kaipapar/Neulatuntimittari/documentation/the_box.md

[25.10.23](25.10.23)
ideas: 
cutting and carving out from oak kitchen counter material.
otherwise should be similar idea to how it started. 
Q: Can the reed + esp + waveshare be in the same box as was the original plan?

the screen is quite big. 37x83.5 mm. I guess the most space efficient way would be to package them all in the same box but fitting it on the Lenco becomes a question.

because the main box needs to contain the screen it will be as big as it will be. Ergo putting the reed switch in there or in it's own box is irrelevant because the main box won't change[^1]

The smaller box(es) shall be identical in dimensions so they'll look nice. Only difference will be an aperture for the IR sensor to see which the reed box wont have. The reed box will just have a hole where where the leads go in and nothing much more.

[^1]: it will change because when I put the reed in the main box there needs to be a crevice for the reed. But it won't change the exterior of the box in any way

#### [25.10.24](25.10.24)
