kaipapar/Neulatuntimittari/documentation/attachments/IMG20250628234006.jpg

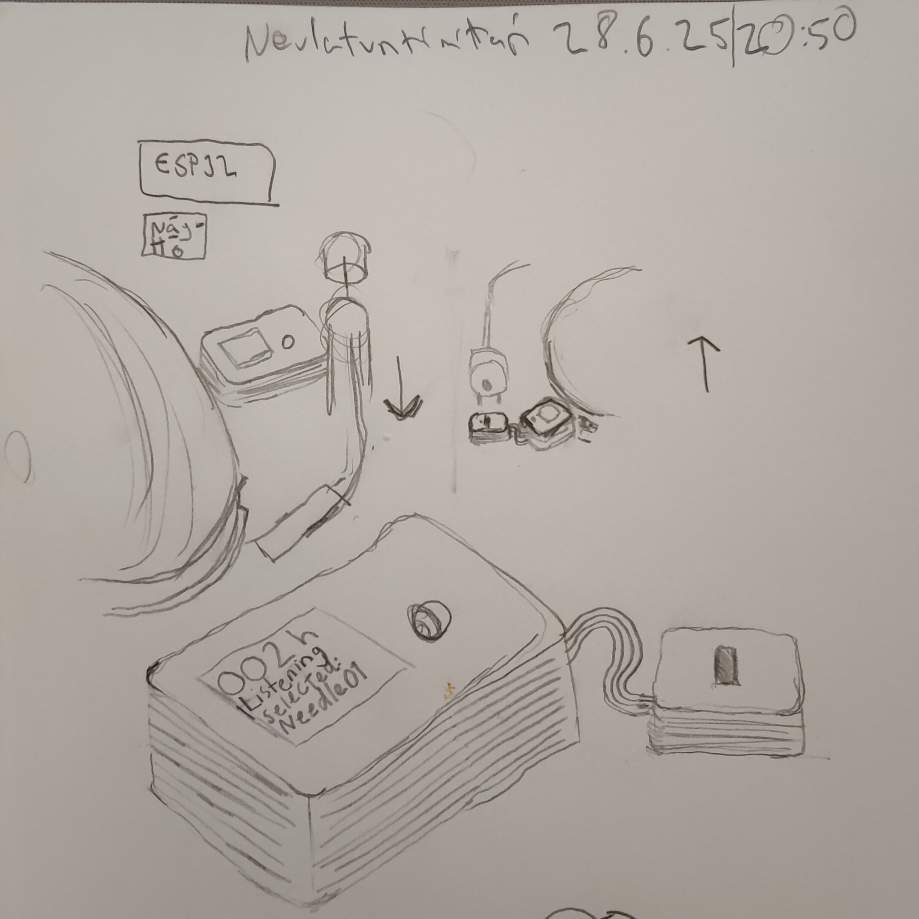
documentation/attachments/IMG20250628234006.jpg
