kaipapar/Neulatuntimittari/documentation/attachments/IMG20250728212540.jpg

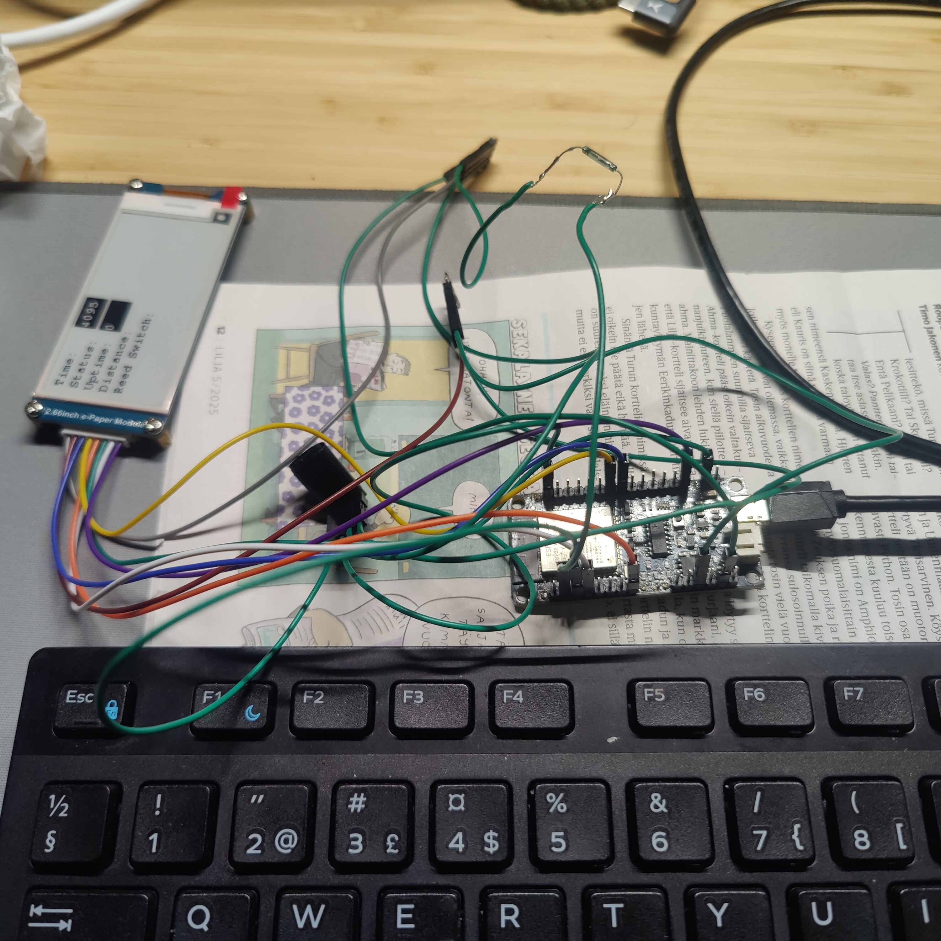
documentation/attachments/IMG20250728212540.jpg
