kaipapar/Neulatuntimittari/documentation/attachments/IMG20251015134359.jpg

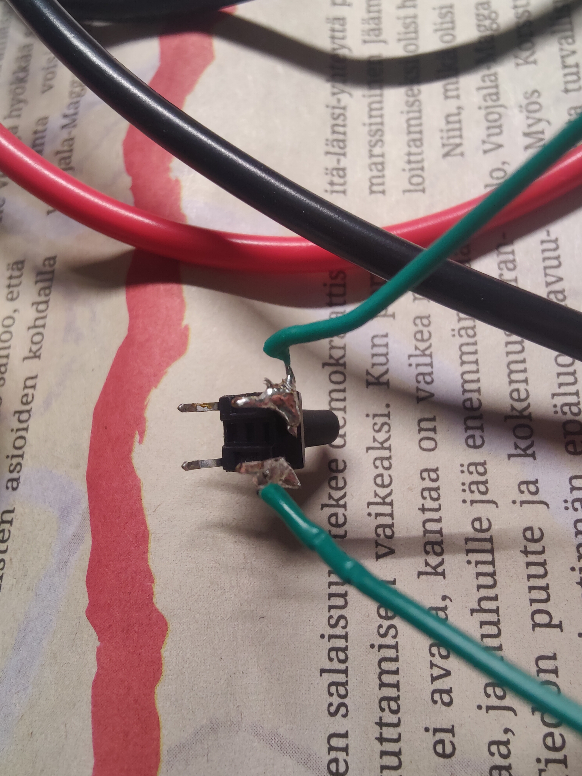
documentation/attachments/IMG20251015134359.jpg
