kaipapar/Neulatuntimittari/documentation/TODO.md

[[25.07.18]]
- [x] uusien kiskojen luomien jostain perseestä noille piikeille, jotka sitä tarvii. Eli virta ja maa, ehkä rst
- [x] E-paperinäytön testaus, jotta olisi pohja näyttää siinä oikeeta dataa
- [x] nappien testaus ja niille joku järkevä käyttötarkoitus.
- [x] Koko roska kasaan!
- [x] Miksi kuvat muissa tiedostoissa kuin Neulatuntimittarissa menee ../../images kansioon??

[25.09.23](25.09.23)
Still todo for this phaze:
- [x] Sleep functionality
	- [x] decide when the state of sleep is activated
	- [x] decide which sleep mode the esp should go into
	- [x] interrupt/wakeup
- [x] Data
	- [x] retrieval
	- [x] saving
	- [x] format
		- [x] CSV format
		- [x] active time logic
		- [ ] 
- [x] UI
	- [x] Printing data clearly
	- [x] UI formatting
	- [ ] Fix flashing in boot?
	- [ ] Error message if something is wrong
		- maybe also flashing internal led
- [x] simplify code structure?
- [x] Update documentation

todo for next phaze:
- [x] Physical implementation
- [x] extra button
	- [x] multiple styli
		- [x] changing styli
		- [x] resetting styli hours
	- [x] rebooting
- [ ] Sleep 2nd phaze
	- [ ] limiting current draw by switching ir sensor off vcc. (with transistor as switch or something like that)
- [x] Rework code into coherent modules?

- [x] writing thorough documentation 
- [x] cleaning codebase to be more coherent
- [x] make box
- [ ] write some post
- [ ]
