kaipapar/Neulatuntimittari/waveshare_test/src/e-ink_partial_update.ino

#if 0
#define ENABLE_GxEPD2_GFX 0

#include <GxEPD2_BW.h> // including both doesn't use more code or ram
#include <GxEPD2_3C.h> // including both doesn't use more code or ram
#include <U8g2_for_Adafruit_GFX.h>

//if you have another microcontroller or another e-ink display module you have to change the following line
GxEPD2_BW<GxEPD2_290_T94_V2, GxEPD2_290_T94_V2::HEIGHT> display(GxEPD2_290_T94_V2(/*CS=5*/ SS, /*DC=*/ 17, /*RST=*/ 16, /*BUSY=*/ 4)); // GDEM029T94, Waveshare 2.9" V2 variant

U8G2_FOR_ADAFRUIT_GFX u8g2Fonts;

void setup()
{
  display.init();
  display.setTextColor(GxEPD_BLACK);
  display.firstPage();
  display.setRotation(1);

  u8g2Fonts.begin(display); // connect u8g2 procedures to Adafruit GFX
  delay(1000);

  uint16_t bg = GxEPD_WHITE;
  uint16_t fg = GxEPD_BLACK;
  u8g2Fonts.setForegroundColor(fg);         // apply Adafruit GFX color
  u8g2Fonts.setBackgroundColor(bg);

  do{
    display.fillScreen(GxEPD_WHITE);

    u8g2Fonts.setFont(u8g2_font_fub20_tr);   //font is set
    u8g2Fonts.setCursor(20, 80);             //cursor(x,y)
    u8g2Fonts.print("Millis: ");   //print the text
  }while (display.nextPage());
}


void loop() {
  display.setPartialWindow(115, 50, 200, 40);
  display.firstPage();

  do{
    display.fillScreen(GxEPD_WHITE);
    u8g2Fonts.setCursor(120, 80);
    u8g2Fonts.print(millis());
  }while(display.nextPage());
}
#endif
