kaipapar/Neulatuntimittari/(commit log)

2025-07-18 blink test added for verifying functionality of switches
2025-07-28 testing and adding new prints to display. Generic function that displays gpio
2025-07-28 Both reed switch and ir sensor print correctly and in real time to waveshare - next up is migrating from test project to main project.
    [main.cpp]
2025-08-17 LittleFS testing csv
    [id_hours.csv]
2025-08-20 add documentation for current progress
2025-09-18 Writing main loop logic * added macro for storing sensor states * added current_time_int function * added state handlers for both reed and dist ++ reed handler seems to work -- dist handler doesn't w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
    [main.cpp]
2025-09-19 Fixed reed and dist outputting * starting to fix timer
    [main.cpp]
2025-09-19 timer implementation and is_reed_active works * is reed active might be buggy still
    [main.cpp]
2025-09-23 deep sleep testing + add sleeptest.cpp and it works * implement the sleeping functionality to main.cpp - even though both inputs are off and state doesn't change it keeps booting up. - other problems?
    [main.cpp, sleeptest.cpp]
2025-09-23 fixed problem with sleep + flipped reed sensor status variable
    [main.cpp, sleeptest.cpp]
2025-09-23 added active timer logic * stores the amount of time spent in active state to be logged into file.
2025-09-25 csv functionalities - file reading works - file writing works-ish - table printing works * for some reason the csv is populated with mumbo jumbo (it does save the correct values set in program, but s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
    [main.cpp]
2025-10-03 saving and retrieving works now, added logic for updating the correct field of the csv
    [main.cpp]
2025-10-03 tweaking ui * set font bigger tweaked locations for the prints etc
2025-10-07 ms to h conversion function. Problems in Real world testing setup, info in obsidian
    [main.cpp]
2025-10-09 implemented interrupt for reed switch * reed polling happens fast enough now! - wakeup pin is always triggered when reed pin is 1, causes boot loop when both sensors are off * NB. No delays currently.
2025-10-09 sleep cycle / bootloop issue fixed * added delay and switched the wakeup pin active state
    [main.cpp, sleep.cpp]
2025-10-13 1. convert hours array to 1d 2. just print the minutes used for testing purposes 3. check 4. linting and other minor things
    [id_hours.csv]
2025-10-13 fixed saving and retrieving function bug * read csv read the strings into uint16_t causing the variable to wrap. + its now uint64_t as it should be...
    [main.cpp]
2025-10-13 start button func - removed some unnecessary lines
2025-10-15 Add button functionality. Not implemented
2025-10-15 more for button logic, made the file more agnostic. Changed internal led 'polarity'
2025-10-16 enabled debug printing * override Serial.print and .println methods with DebugPrint macros for using debug prints or not * all prints can be disabled via platformio.ini build_flags
2025-10-16 convert some debug prints to current format
2025-10-16 not tested fully: button logic done ish and changed table to array * saving or retrieving (or both) don't work
2025-10-21 button implemented - fast press tested, slow press tested, also superslow tested * i think both presses are a bit unresponsive
2025-10-21 switch debug system state off, enable printing hours to waveshare
